GameMoon/esp8266-homeaut/doc/content/planning.tex

% két bekezdés minden kapcsolási modulról
\chapter{Tervezés}

\input{content/circuit_parts}
\newpage
\input{content/software}
