GameMoon/esp8266-homeaut/doc/content/literature_review.tex

% Szakdolgozat, diplomaterv esetén a dolgozat felépítése valami ehhez hasonló, témától függetlenül lehet természetesen eltérés:
% -Bevezetés, 1-2 oldal, a téma elhelyezése, miről lesz szó
% -Szakirodalmi áttekintés: a dolgozat kb harmada, szükséges előismereteket tartalmazza, illetve szakdolgozat esetén kb 5, diplomaterv esetén kb 10 szakmai cikk hivatkozása, 
%   1-1 bekezdésben összefoglalva, kik, mivel mit csináltak, milyen eredményre jutottak, az aktuális dolgozathoz hogy kapcsolódik, 
%   miért releváns. Kutatós témák esetén ez lényegesen nagyobb hangsúlyt kap (több cikk is hivatkozható!), 
%   fejlesztős feladatok esetén hasonló termékek bemutatása, elmélet amire a tervezés (a későbbiekben bemutatandó munka) épül.
% -Tervezés (témától függően más is lehet a fejezet címe): A saját munka bemutatása. Hardver fejlesztős dolgozat esetén kapcsolási rajz részletek megmagyarázva stb.
% -Értékelés: Szimulációs eredmények, valós mérések bemutatása, a megvalósítás mennyire sikerült, eltérések a várttól.
% -Összefoglalás: a dolgozat összefoglalása, kb 1-2 oldal, jövőbeli tervek.
% A szakirodalmakhoz lehet használni guglit, de ne ez legyen az első. Tanszéki és kolis hálóról elérhetőek online folyóiratok, ez a legjobb forrás (gugli is indexel) pl:
% -IEEE Xplore
% -Elsevier
% -Springerlink
% (-Google scholar)
% -stb
% A wikipedia, youtube és online hírportálok hivatkozását lehetőleg mindenki kerülje. Ha mégis nagyon releváns, ők is hivatkozni szoktak az eredeti forrásra, azt nézzétek meg.
% Szakirodalmak feldolgozása:
% -Absztrakt elolvasása, el kell dönteni, hogy releváns-e a cikk vagy sem
% -Bevezetés átolvasása, általában egy jó áttekintése a témakörnek
% -Ábrák átnézése
% -Conclusion rész elolvasása
% -Aki jobban el akar merülni benne, a többi rész is elolvashatóíy
% -Ezek alapján néhány mondatos összefoglaló generálása

\chapter{Szakirodalmi áttekintés}

\section{Smart building based on IoT }
A cikkben\cite{smartbuildingiot:article} a rendszer létrehozás során különböző típus szenzorokat helyeztek el mindegyeik szobában, amelyek segítségével monitorozni tudták a víz, illetve áramfogyasztásokat. Emelett külön lehetett detektálni, hogy vannak-e az egyes szobákba, illtve vezérelhető volt világítás is.

A projekt célja a lakás biztonságának növelése és környezetbarátabbá tétele volt. Probléma esetén tud generálni a hatóságoknak egy egyedi képet, amin nincsennek személyes információk csak olyan alapvető paraméterek, hogy melyik szobában van a tűz.

A hálózat legalsó részén találhatóak szobában elhelyezz ESP32 egységek, amelyek WiFi-vel kommunikálnak az egyel felettük lévő LoraWAN használatára képes LoPy eszközökkel. Ezek az eszközök továbbítják az adatokat egy felhőbe. A felhőben futő NodeRed segítségével pedig tudják gyűjteni az adatokat, illetve irányítani a szobában található egységeket.
