GameMoon/esp8266-homeaut/doc/figures/leds.PNG

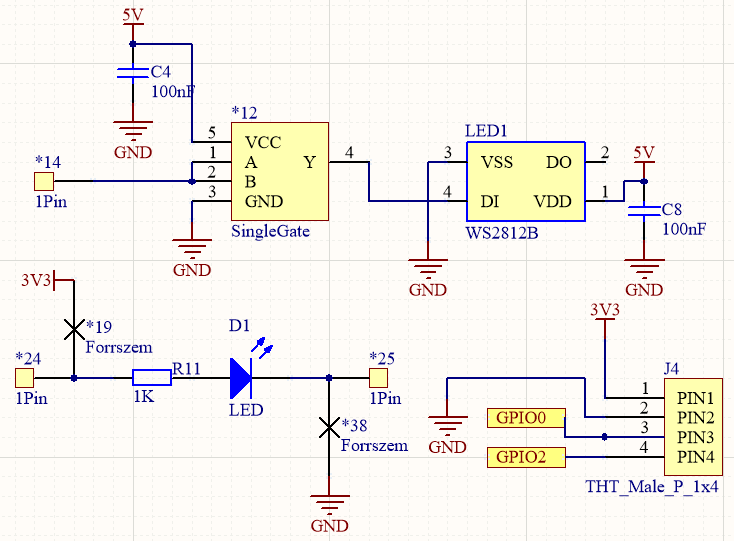
doc/figures/leds.PNG
