GameMoon/esp8266-homeaut/doc/figures/nfet_driver.PNG

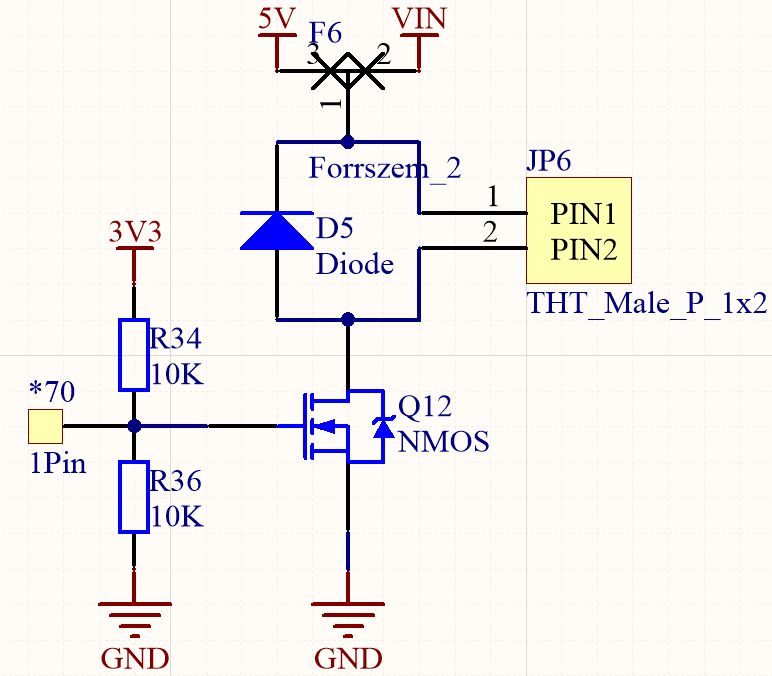
doc/figures/nfet_driver.PNG
