GameMoon/esp8266-homeaut/doc/figures/nfet_driver_3v3.PNG

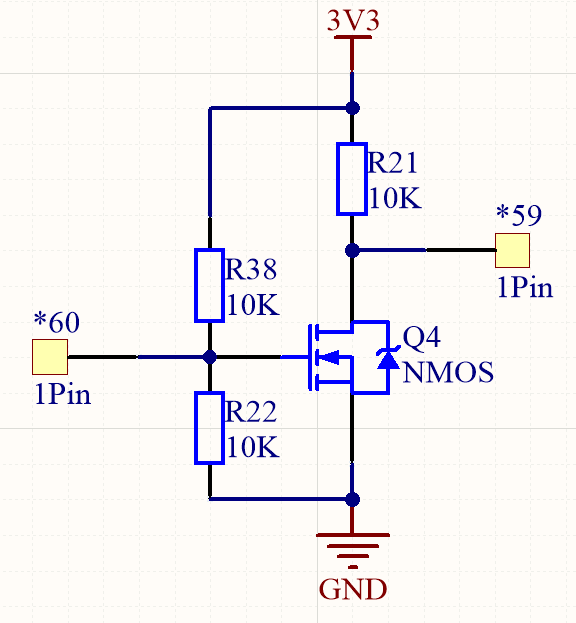
doc/figures/nfet_driver_3v3.PNG
