GameMoon/esp8266-homeaut/doc/figures/pfet_driver.png

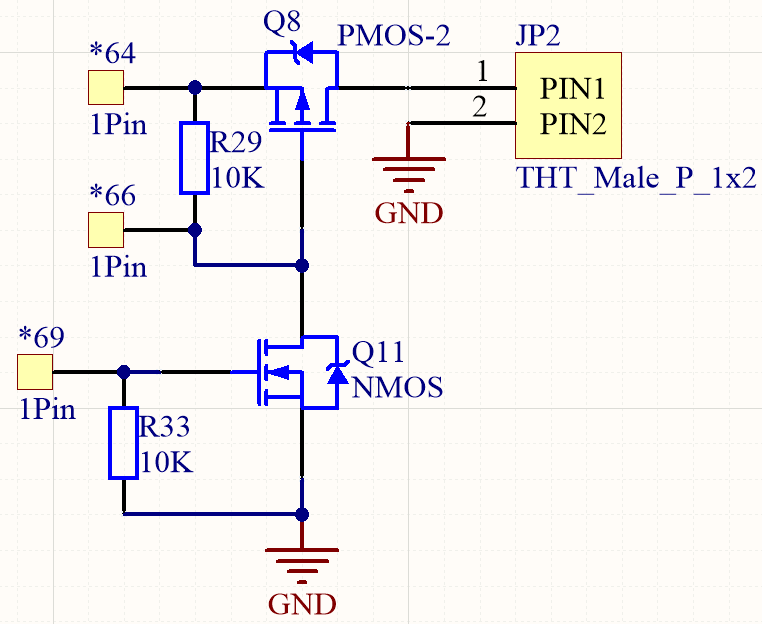
doc/figures/pfet_driver.png
