GameMoon/esp8266-homeaut/(list of files, drawings)

Other design files:
kiindulas/Keep_Talking/02_ESP12_CORE.SchDoc
kiindulas/Keep_Talking/Display.SchDoc
kiindulas/Keep_Talking/ESPModulv2.PcbDoc
kiindulas/Keep_Talking/Modul.SchDoc
kiindulas/Keep_Talking/Onlab.PrjPcb
kiindulas/MagicArduinoKartya/MagicArduinoKartya.PrjPcb
kiindulas/MagicArduinoKartya/PCB3.PcbDoc
kiindulas/MagicArduinoKartya/Sheet1.SchDoc
kiindulas/MagicArduinoKartya/Sheet2.SchDoc
kiindulas/MagicArduinoKartya/Sheet3.SchDoc
kiindulas/MyLib/MySch.SchLib
nyak/board.PcbDoc
nyak/core.SchDoc
nyak/esp8266home.PrjPCB
nyak/fetdrivers.SchDoc
nyak/peripheries.SchDoc
nyak/power.SchDoc
