GameMoon/esp8266-homeaut/(commit log)

2019-09-24 core + usbuart parts added
    [MySch.SchLib, core.SchDoc, esp8266home.PrjPCB, peripheries.SchDoc, usb-uart.SchDoc]
2019-10-09 perferies, programmer and pin headers added
    [MySch.SchLib, core.SchDoc, esp8266home.PrjPCB, peripheries.SchDoc, power.SchDoc, usb-uart.SchDoc]
2019-10-14 shift register changed to i2c, more perifereis, power
    [MySch.SchLib, core.SchDoc, esp8266home.PrjPCB, mainboard.PcbDoc, peripheries.SchDoc, power.SchDoc]
2019-10-24 first version of pcb
    [MySch.SchLib, board.PcbDoc, core.SchDoc, esp8266home.PrjPCB, fetdrivers.SchDoc, mainboard.PcbDoc, peripheries.SchDoc, power.SchDoc]
2019-10-27 routing done except gnd
    [board.PcbDoc, core.SchDoc, fetdrivers.SchDoc, peripheries.SchDoc, power.SchDoc]
2019-10-27 gnd pour added
    [board.PcbDoc]
2019-10-30 pin headers, outline added
    [board.PcbDoc, core.SchDoc, peripheries.SchDoc, power.SchDoc]
2019-10-30 holes fix
    [board.PcbDoc]
2019-10-30 supply labels, outline, opto default gnd added
    [board.PcbDoc, peripheries.SchDoc]
2019-11-03 ground pour fix, gerbers generated
    [board.PcbDoc, esp8266home.PrjPCB, peripheries.SchDoc]
2019-11-04 fixed via collision
    [board.PcbDoc, esp8266home.PrjPCB]
2019-12-01 Menu system finished Encoder movement fixed
    [Config.h, DisplayItem.h, DisplayManager.cpp, DisplayManager.h, Encoder.cpp, Encoder.h, HomeAUT.ino, Outputs.h]
2019-12-07 fet, shiftregister, opto, i2c added
2019-12-10 circuit parts and software part added
    [board.PcbDoc, core.SchDoc, esp8266home.PrjPCB, fetdrivers.SchDoc, peripheries.SchDoc, power.SchDoc]
2020-03-21 fixed capacitor and middle connector
    [board.PcbDoc, esp8266home.PrjPCB, power.SchDoc]
2020-03-21 test application
    [config.txt]
2020-03-21 alitum save
    [board.PcbDoc, esp8266home.PrjPCB]
